RmnRss/Roboteach/Roboteach_Python/Read_Me.txt

Téléverser FirmataStandarPlus Dans l'UNO avant de lancer exec.py
