RmnRss/Roboteach/Roboteach_Doc_Interface/Details_Prix_Composants.ods

Composants | Quantité / carte | Prix Unitaire | Sous-Total | Liens | TOTAL / Cartes
CARTE ARDUINO UNO | 1 | 20 | 20 | https://store.arduino.cc/arduino-uno-rev3 | 37,54
REGISTRE A DECALAGE - 74HC165 | 1 | 0,33 | 0,33 | https://fr.rs-online.com/web/p/compteurs-et-registres-a-decalage/3332978/
DRIVERS MOTEUR - L298 | 2 | 4,41 | 8,82 | https://fr.rs-online.com/web/p/drivers-de-moteur/0636384/
DIODES - 4148 | 16 | 0,052 | 0,832 | https://fr.rs-online.com/web/p/diodes-de-commutation/7390290/ | Optionel
RESISTANCES 10k | 10 | 0,13 | 1,3 | https://fr.rs-online.com/web/p/products/7077745/?tpr=3
CONDENSATEURS 100 nF | 4 | 0,2 | 0,8 | https://fr.rs-online.com/web/p/condensateurs-ceramique-multicouche/5381310/
CONSENSATEURS 470 uF / 16V | 1 | 0,108 | 0,108 | https://fr.rs-online.com/web/p/condensateurs-aluminium/7111110/
CONNECTEURS 20 PIN | 1 | 0,4 | 0,4 | https://www.gotronic.fr/art-connecteur-mh220-4467.htm
CONNECTEURS Classiques | 1 | 0,6 | 0,6 | https://www.gotronic.fr/art-connecteur-he14-mh100-4457.htm
CONNECTEURS Tulipes | 1 | 0,95 | 0,95 | https://www.gotronic.fr/art-barrette-secable-stb32-4622.htm
PLAQUE EPOXY DOUBLE FACE 10x16 cm | 1 | 3,4 | 3,4 | https://www.gotronic.fr/art-epoxy-presensibilise-20091.htm
Pont redresseur Monophasé, 1A 50V | 4 | 0,195 | 0,78 | https://fr.rs-online.com/web/p/ponts-redresseurs/9189266/
