RmnRss/Roboteach/Roboteach_Doc_Interface/Boite_3D/Boitier.stl

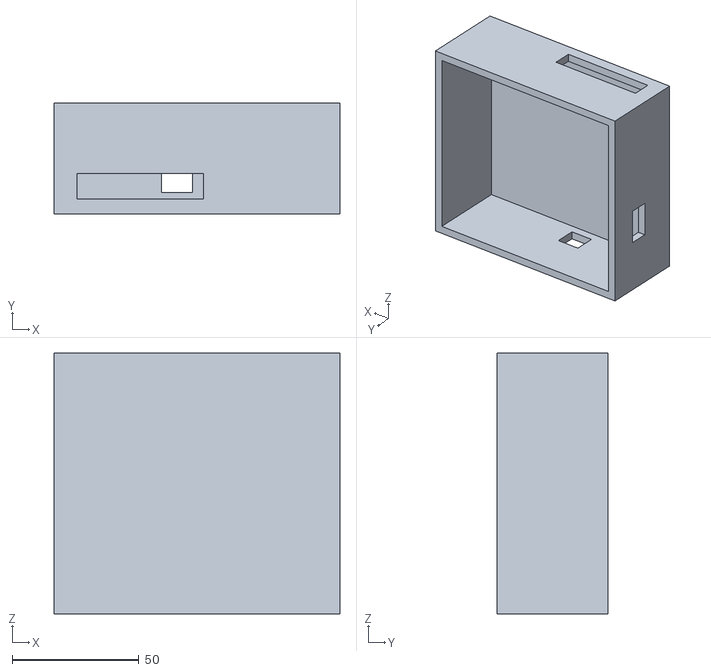
[picture p1: CAD file, 2018-06-28]
Roboteach_Doc_Interface/Boite_3D/Boitier.stl
113.0 x 44.0 x 103.0
