RmnRss/Roboteach/Roboteach_Doc_Interface/Boite_3D/Couvercle.stl

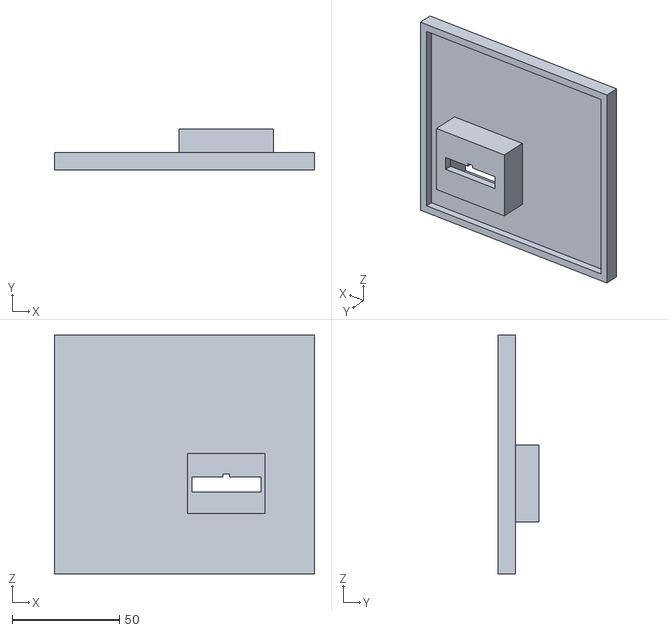
[picture p2: CAD file, 2018-06-28]
Roboteach_Doc_Interface/Boite_3D/Couvercle.stl
121.0 x 19.0 x 111.0
