RmnRss/Roboteach/Roboteach_Doc_Interface/Documents_EAGLE/Typon_Bot_V3.pdf

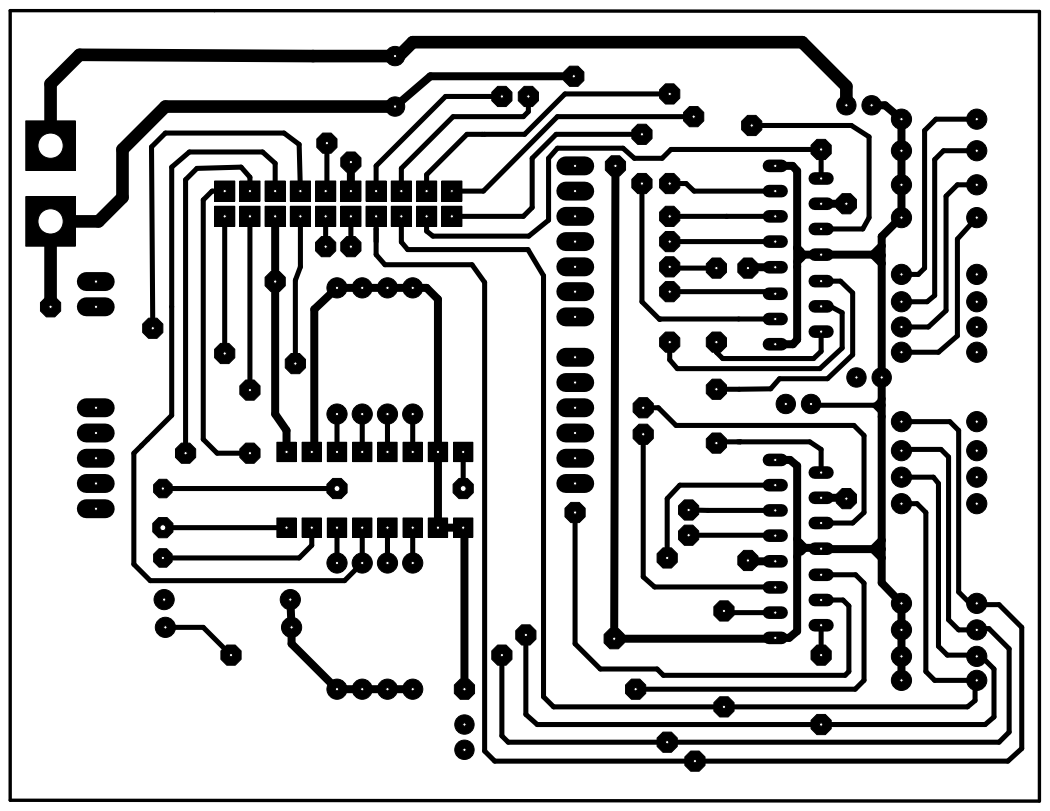
[picture p3: page 1]
