RmnRss/Roboteach/Roboteach_Doc_Interface/Documents_EAGLE/Typon_Top_V3.pdf

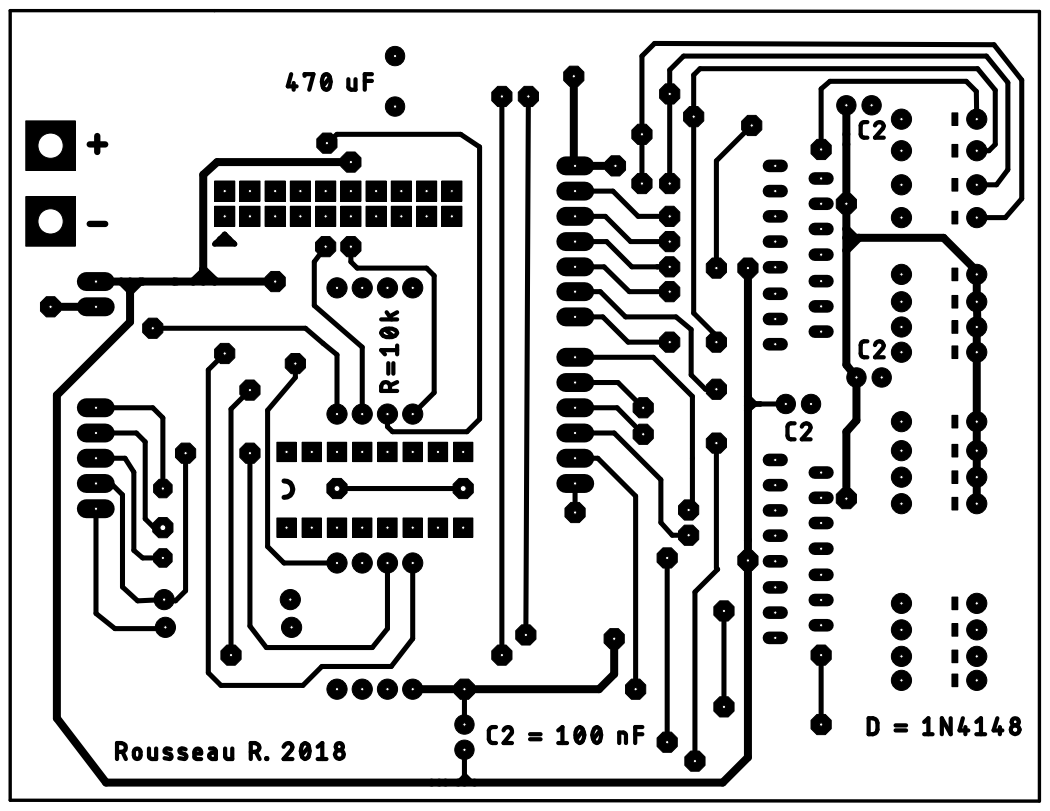
[picture p4: page 1]
