RmnRss/Roboteach/Roboteach_Doc_Interface/Documents_EAGLE/Carte_Fischertechnik_V3/Carte_Fischertechnik_V3.brd

## EAGLE design Roboteach_Doc_Interface/Documents_EAGLE/Carte_Fischertechnik_V3/Carte_Fischertechnik_V3.brd (2018-06-28)

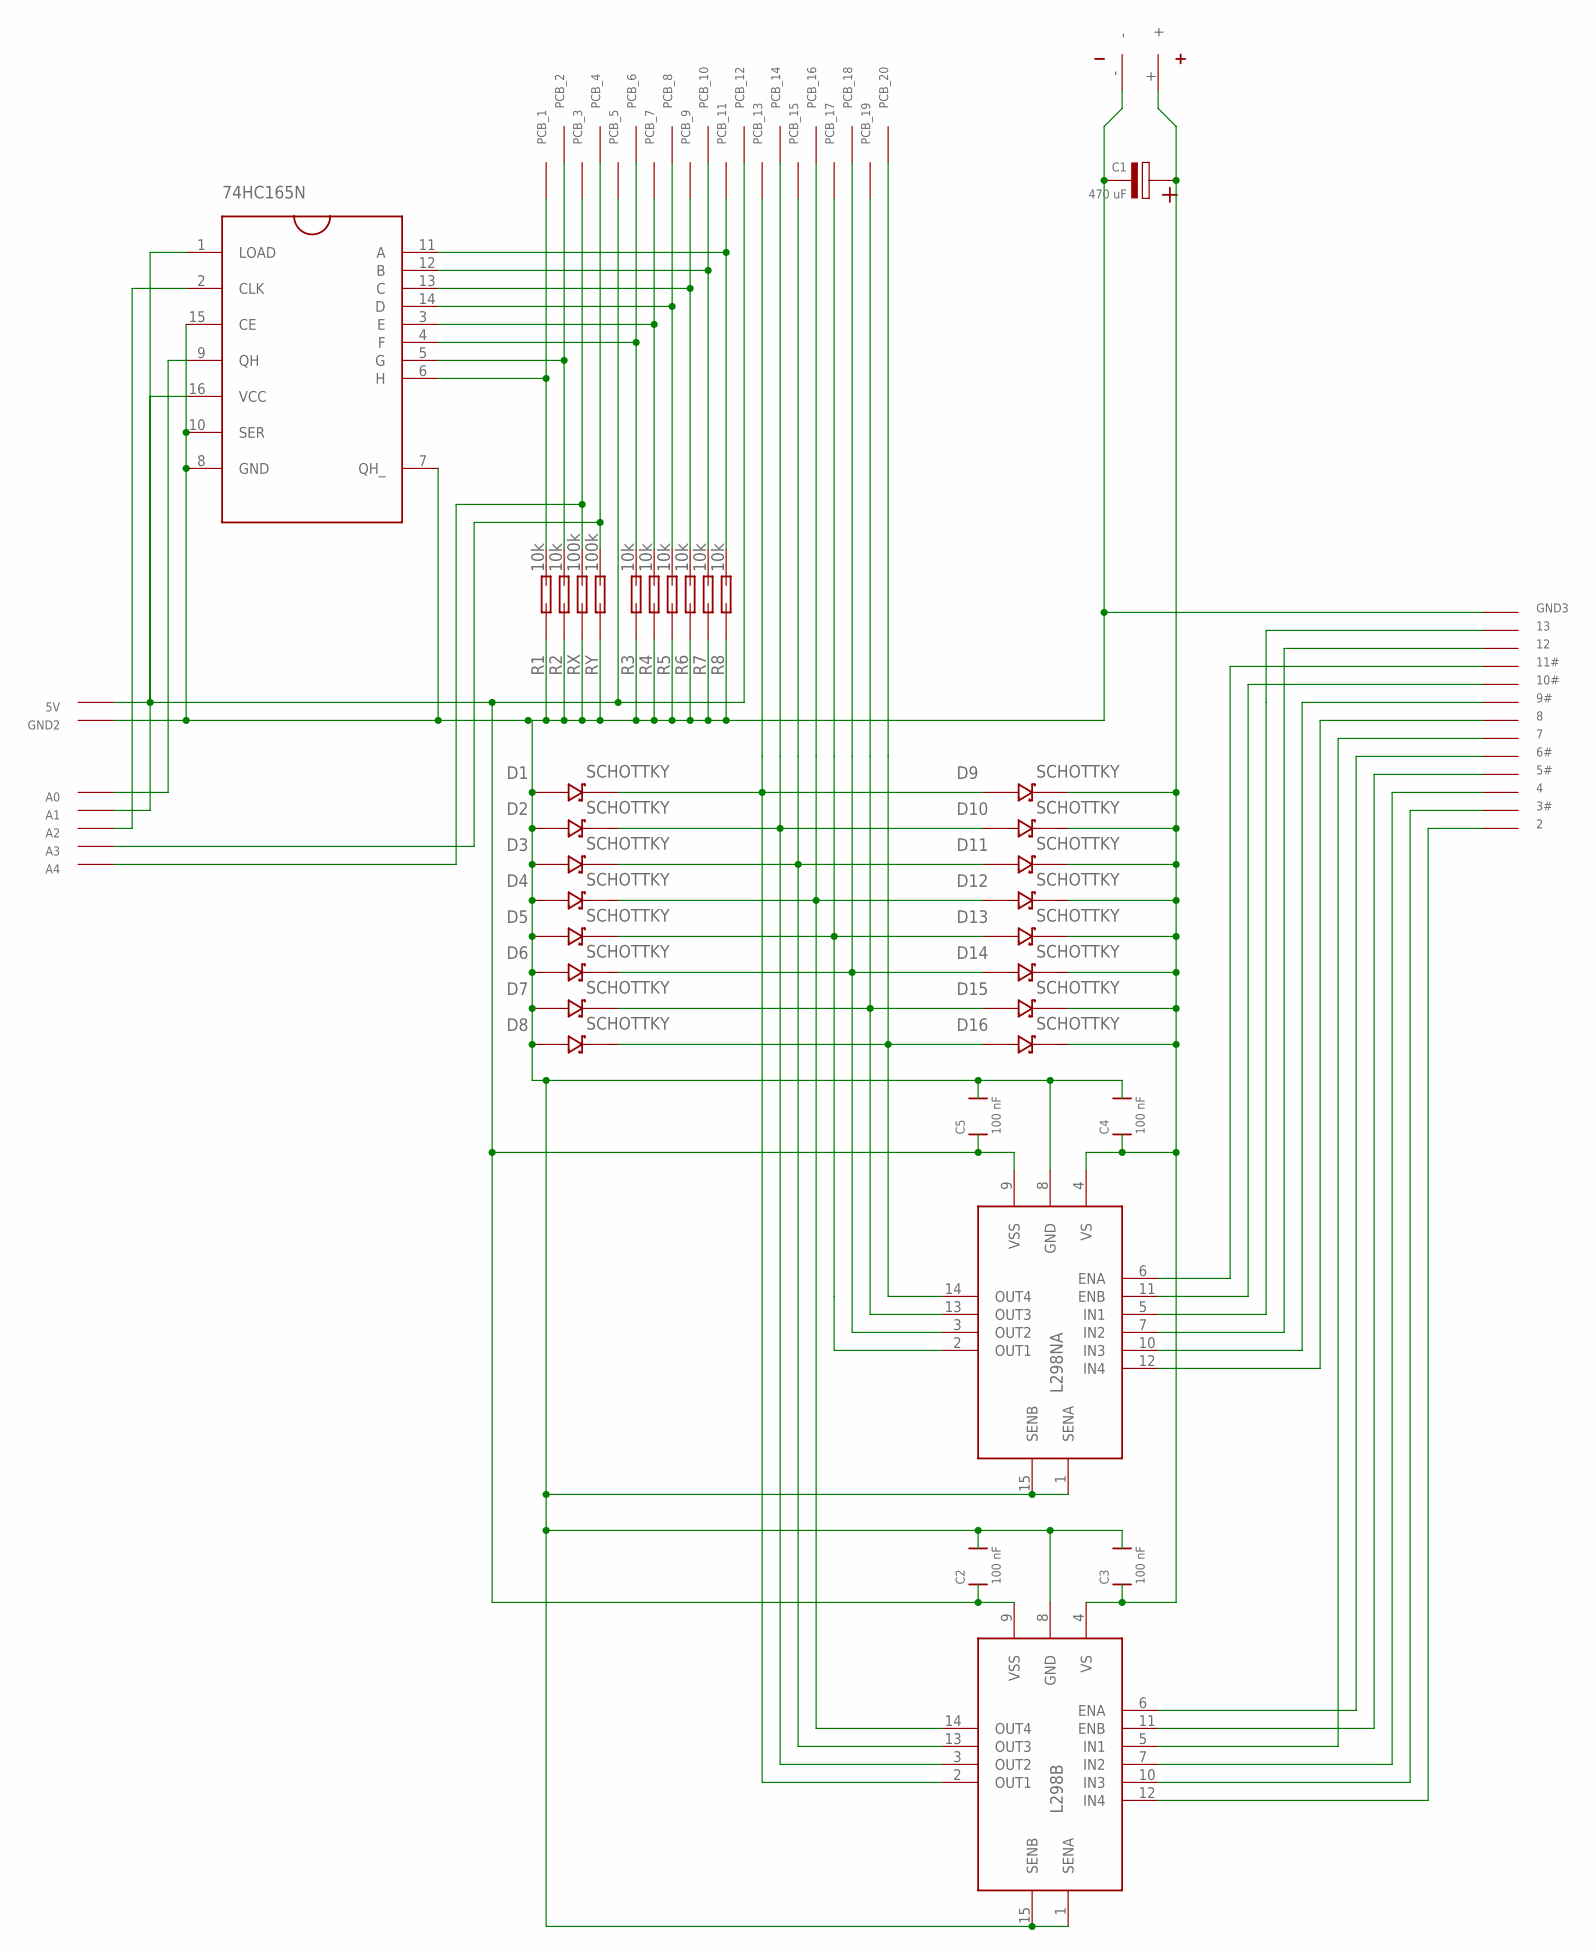
[picture p5: schematic Carte_Fischertechnik_V3.sch]

Parts:
2, 3#, 4, 5#, 6#, 7, 8, 9#, 10#, 11#, 12, 13: PAD_O
5V: 5V; PAD_O
74HC165N: 74HC165N
A0, A1, A2, A3, A4: PAD_O
C1: 470 uF; POLARIZED_CAPACITOR
C2, C3, C4, C5: 100 nF; CAPACITOR
D1, D2, D3, D4, D5, D6, D7, D8, D9, D10, D11, D12, D13, D14, D15, D16: SCHOTTKY
GND2: GND; PAD_O
GND3: PAD_O
L298B, L298NA: L298N
PCB_1, PCB_2, PCB_3, PCB_4, PCB_5, PCB_6, PCB_7, PCB_8, PCB_9, PCB_10, PCB_11, PCB_12, PCB_13, PCB_14, PCB_15, PCB_16, PCB_17, PCB_18, PCB_19, PCB_20: PAD_C
R1, R2, R3, R4, R5, R6, R7, R8: 10k; RESISTANCE
RX: 100k; RESISTANCE
RY: 100k; RESISTANCE
U$1: ADAPTATEUR_FTK

Connections:
unnamed: D1.+, D9.-, L298B.2 (OUT1), PCB_13.$1
unnamed: 5V.P$1, 74HC165N.16 (VCC), C2.P$1, C5.P$1, L298B.9 (VSS), L298NA.9 (VSS), PCB_5.$1, PCB_12.$1
unnamed: 74HC165N.5 (G), PCB_2.$1, R2.P$2 (B)
unnamed: D2.+, D10.-, L298B.3 (OUT2), PCB_14.$1
unnamed: D3.+, D11.-, L298B.13 (OUT3), PCB_15.$1
unnamed: 74HC165N.7 (QH_), 74HC165N.8 (GND), 74HC165N.10 (SER), 74HC165N.15 (CE), C1.P$2 (-), C2.P$2, C3.P$2, C4.P$2, C5.P$2, D1.-, D2.-, D3.-, D4.-, D5.-, D6.-, D7.-, D8.-, GND2.P$1, GND3.P$1, L298B.1 (SENA), L298B.8 (GND), L298B.15 (SENB), L298NA.1 (SENA), L298NA.8 (GND), L298NA.15 (SENB), R1.P$1 (A), R2.P$1 (A), R3.P$1 (A), R4.P$1 (A), R5.P$1 (A), R6.P$1 (A), R7.P$1 (A), R8.P$1 (A), RX.P$1 (A), RY.P$1 (A), U$1.-
unnamed: D5.+, D13.-, L298NA.2 (OUT1), PCB_17.$1
unnamed: C1.P$1 (+), C3.P$1, C4.P$1, D9.+, D10.+, D11.+, D12.+, D13.+, D14.+, D15.+, D16.+, L298B.4 (VS), L298NA.4 (VS), U$1.+
unnamed: D4.+, D12.-, L298B.14 (OUT4), PCB_16.$1
unnamed: 74HC165N.9 (QH), A0.P$1
unnamed: 74HC165N.2 (CLK), A2.P$1
unnamed: 74HC165N.1 (LOAD), A1.P$1
unnamed: 74HC165N.6 (H), PCB_1.$1, R1.P$2 (B)
unnamed: A4.P$1, PCB_3.$1, RX.P$2 (B)
unnamed: A3.P$1, PCB_4.$1, RY.P$2 (B)
unnamed: 74HC165N.4 (F), PCB_6.$1, R3.P$2 (B)
unnamed: 74HC165N.3 (E), PCB_7.$1, R4.P$2 (B)
unnamed: 74HC165N.14 (D), PCB_8.$1, R5.P$2 (B)
unnamed: 74HC165N.13 (C), PCB_9.$1, R6.P$2 (B)
unnamed: 74HC165N.12 (B), PCB_10.$1, R7.P$2 (B)
unnamed: 74HC165N.11 (A), PCB_11.$1, R8.P$2 (B)
unnamed: 11#.P$1, L298NA.6 (ENA)
unnamed: 10#.P$1, L298NA.11 (ENB)
unnamed: 13.P$1, L298NA.5 (IN1)
unnamed: 12.P$1, L298NA.7 (IN2)
unnamed: D6.+, D14.-, L298NA.3 (OUT2), PCB_18.$1
unnamed: D7.+, D15.-, L298NA.13 (OUT3), PCB_19.$1
unnamed: D8.+, D16.-, L298NA.14 (OUT4), PCB_20.$1
unnamed: 9#.P$1, L298NA.10 (IN3)
unnamed: 8.P$1, L298NA.12 (IN4)
unnamed: 7.P$1, L298B.5 (IN1)
unnamed: 6#.P$1, L298B.6 (ENA)
unnamed: 5#.P$1, L298B.11 (ENB)
unnamed: 4.P$1, L298B.7 (IN2)
unnamed: 3#.P$1, L298B.10 (IN3)
unnamed: 2.P$1, L298B.12 (IN4)

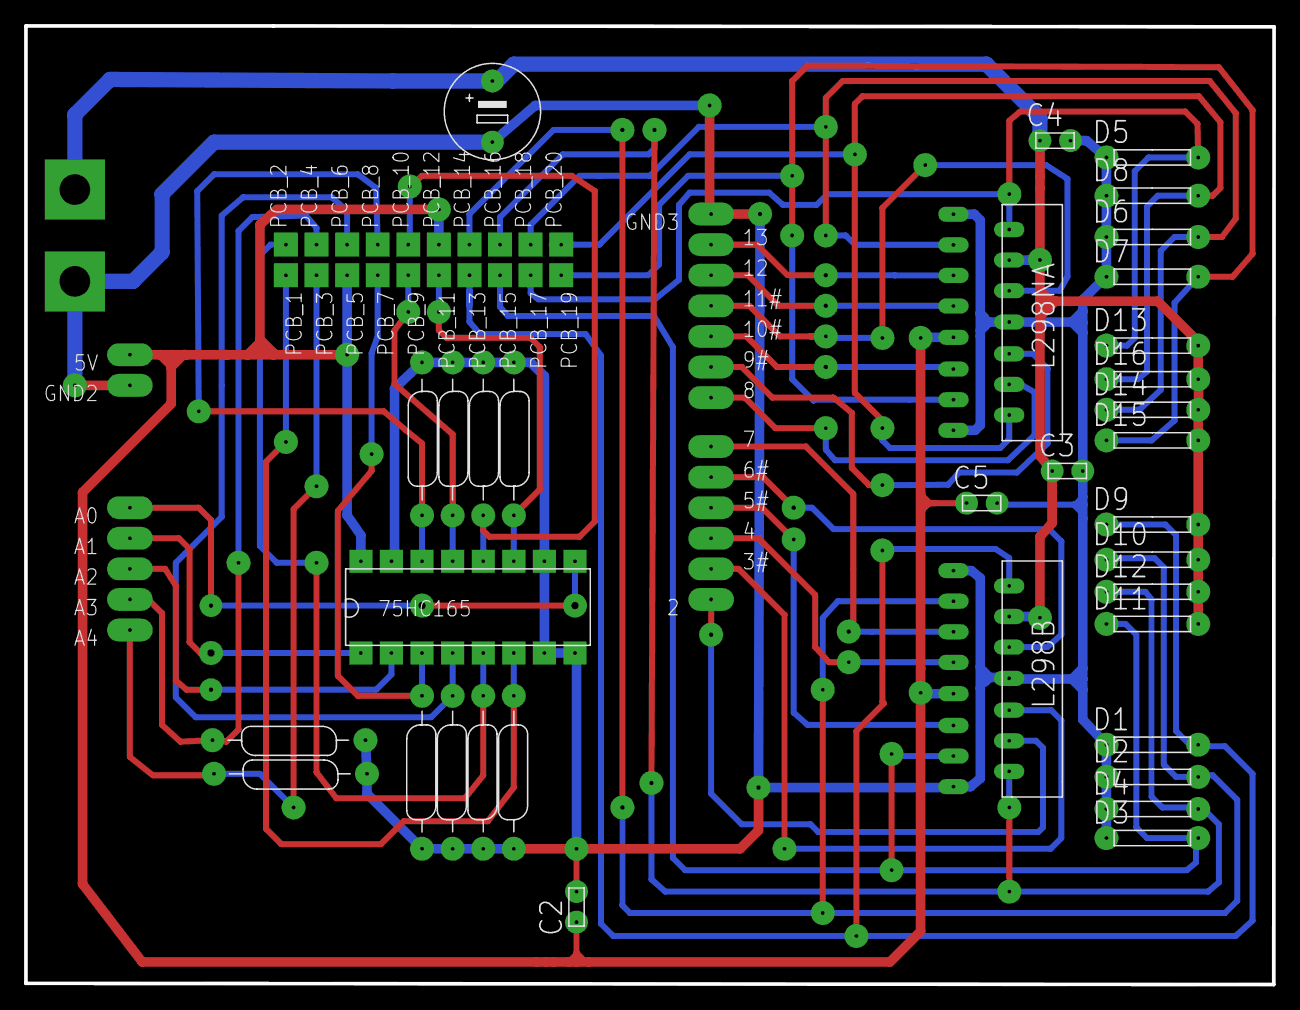
[picture p6: board Carte_Fischertechnik_V3.brd from above]

Board: 2 copper layers, 103.6 x 79.6 mm, 75 parts (0 on the bottom side), 36 nets.
