RmnRss/Roboteach/Roboteach_Test_Arduino/Pin_map.h

//Branchement des pins sur Arduino MEGA

//Pins M4
#define L298A_ENA 2
#define L298A_IN1 3
#define L298A_IN2 4

//Pins M3
#define L298A_ENB 7
#define L298A_IN3 5 
#define L298A_IN4 6

//Pins M2
#define L298B_ENA 8 
#define L298B_IN1 9
#define L298B_IN2 10

//Pins M1
#define L298B_ENB 13
#define L298B_IN3 11
#define L298B_IN4 12

//Pins Registre a décalage
#define DATA      54
#define LOAD      55 
#define CLOCK     56

//Pins entrees Analogique
#define ANALOGX   A3
#define ANALOGY   A4

//Branchement des pins sur Arduino UNO

//Pins M4
#define L298A_ENA 2
#define L298A_IN1 3
#define L298A_IN2 4

//Pins M3
#define L298A_ENB 7
#define L298A_IN3 5 
#define L298A_IN4 6

//Pins M2
#define L298B_ENA 8 
#define L298B_IN1 9
#define L298B_IN2 10

//Pins M1
#define L298B_ENB 13
#define L298B_IN3 11
#define L298B_IN4 12

//Pins Registre a décalage sur UNO
#define SER_OUT   14
#define SHLD      15
#define CLOCK     16

//Pins entrees Analogique
#define ANALOGX   A3
#define ANALOGY   A4
