RmnRss/Roboteach/(commit log)

2018-06-01 Fichiers mBlock - Bug e-binaires 1bloc
    Fonctionnel sauf binaires qui demande 2 appuis
    [RoboTeach.js]
2018-06-28 Python Fonctionnel
    Ajout de la classe Fischertechnik permettant de piloter les éléments depuis Python 3.6 grâce à la bibliotèque PyMata_AIO
2018-06-28 Nettoyage et Ajout
    Ajout des Documents - Datasheets, Pin Map, Projet EAGLE etc.
    [Boitier.stl, Carte_Fischertechnik_V3.brd, Carte_Fischertechnik_V3.sch, Couvercle.stl, Details_Prix_Composants.ods, Map_Adaptateur_Vers_Carte.ods]
